xtompok/flipdot-driver/README.md

# flipdot-driver
Driver for flipdot displays
