xtompok/flipdot-driver/hw/flipdot-driver/flipdot-driver.kicad_pcb

## KiCad design hw/flipdot-driver/flipdot-driver.kicad_pcb (2019-07-27)

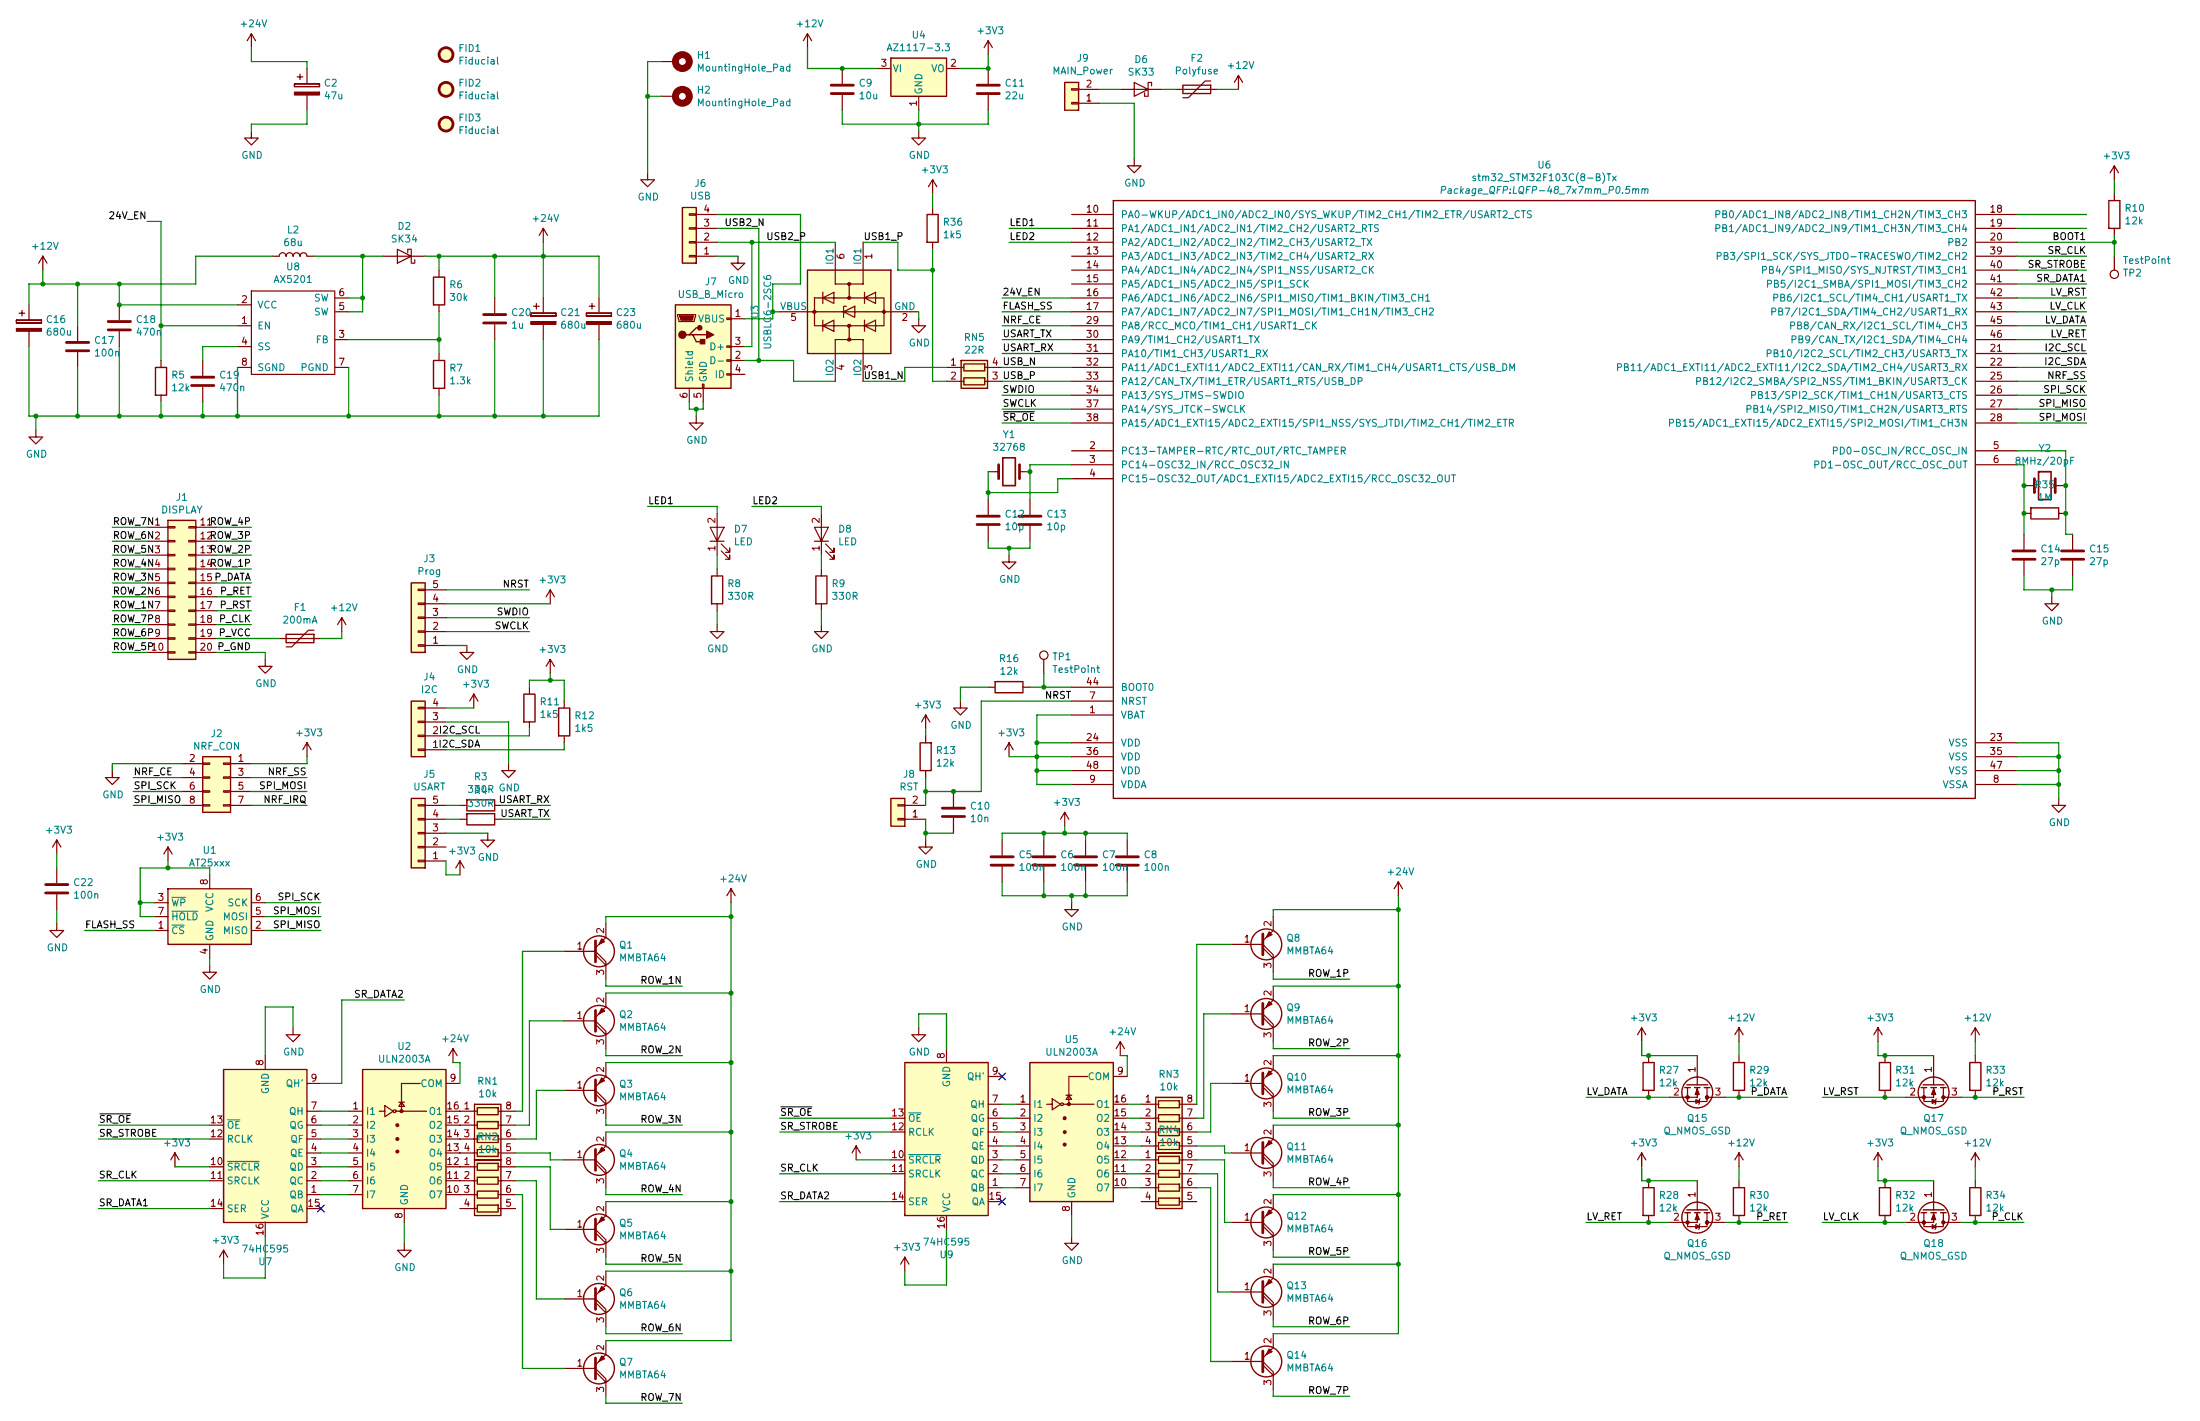
[picture p1: schematic flipdot-driver.sch, Flipdot Driver]

Parts:
C2: 47u; CP_Radial_D6.3mm_P2.50mm
C5, C6, C7, C8, C17, C22: 100n; C_0603_1608Metric
C9: 10u; C_0805_2012Metric
C10: 10n; C_0603_1608Metric
C11: 22u; C_0805_2012Metric
C12, C13: 10p; C_0603_1608Metric
C14, C15: 27p; C_0603_1608Metric
C16, C21, C23: 680u; CP_Radial_D10.0mm_P5.00mm
C18, C19: 470n; C_0603_1608Metric
C20: 1u; C_0603_1608Metric
D2: SK34; D_SMC
D6: SK33; D_SMC
D7, D8: LED; LED_D3.0mm
F1: 200mA; Fuse_1206_3216Metric
F2: Polyfuse; Fuse_1812_4532Metric
FID1, FID2, FID3: Fiducial; Fiducial_0.75mm_Dia_1.5mm_Outer
H1, H2: MountingHole_Pad; MountingHole_3.2mm_M3_DIN965_Pad
J1: DISPLAY; IDC-Header_2x10_P2.54mm_Vertical
J2: NRF_CON; PinSocket_2x04_P2.54mm_Vertical
J3: Prog; Molex_KK-254_AE-6410-05A_1x05_P2.54mm_Vertical
J4: I2C; Molex_KK-254_AE-6410-04A_1x04_P2.54mm_Vertical
J5: USART; Molex_KK-254_AE-6410-05A_1x05_P2.54mm_Vertical
J6: USB; Molex_KK-254_AE-6410-04A_1x04_P2.54mm_Vertical
J7: USB_B_Micro; USB_Micro-B
J8: RST; PinSocket_1x02_P2.54mm_Vertical
J9: MAIN_Power; PhoenixContact_MC-G_02x3.81mm_Angled
L2: 68u; L_12x12mm_H8mm
Q1, Q2, Q3, Q4, Q5, Q6, Q7, Q8, Q9, Q10, Q11, Q12, Q13, Q14: MMBTA64; SOT23-3
Q15, Q16, Q17, Q18: Q_NMOS_GSD; SOT-23
R3, R4, R8, R9: 330R; R_0603_1608Metric
R5, R10, R13, R16, R27, R28, R29, R30, R31, R32, R33, R34: 12k; R_0603_1608Metric
R6: 30k; R_0603_1608Metric
R7: 1.3k; R_0603_1608Metric
R11, R12, R36: 1k5; R_0603_1608Metric
R35: 1M; R_0603_1608Metric
RN1, RN2, RN3, RN4: 10k; R_Array_Convex_4x0603
RN5: 22R; R_Array_Convex_2x0402
TP1, TP2: TestPoint; TestPoint_THTPad_2.5x2.5mm_Drill1.2mm
U1: AT25xxx; SO-8_5.3x6.2mm_P1.27mm
U2, U5: ULN2003A; SOIC-16_3.9x9.9mm_P1.27mm
U3: USBLC6-2SC6; SOT-23-6
U4: AZ1117-3.3; SOT-223-3_TabPin2
U6: stm32_STM32F103C(8-B)Tx; LQFP-48_7x7mm_P0.5mm
U7, U9: 74HC595; SOIC-16_3.9x9.9mm_P1.27mm
U8: AX5201; HSOP-8-1EP_3.9x4.9mm_P1.27mm_EP2.41x3.1mm
Y1: 32768; Crystal_Round_D3.0mm_Vertical
Y2: 8MHz/20pF; Crystal_HC49-U_Vertical

Connections:
+3V3: C5.1, C6.1, C7.1, C8.1, C11.1, C22.1, J2.1, J3.4, J4.4, J5.1, Q15.1 (G), Q16.1 (G), Q17.1 (G), Q18.1 (G), R10.1, R11.1, R12.1, R13.2, R27.1, R28.1, R31.1, R32.1, R36.1, U1.3 (~WP), U1.7 (~HOLD), U1.8 (VCC), U4.2 (VO), U6.1 (VBAT), U6.9 (VDDA), U6.24 (VDD), U6.36 (VDD), U6.48 (VDD), U7.10 (~SRCLR), U7.16 (VCC), U9.10 (~SRCLR), U9.16 (VCC)
+12V: C9.1, C16.1, C17.1, C18.1, F1.1, F2.1, L2.1, R29.1, R30.1, R33.1, R34.1, U4.3 (VI), U8.2 (VCC)
+24V: C2.1, C20.1, C21.1, C23.1, D2.1 (K), Q1.2 (E), Q2.2 (E), Q3.2 (E), Q4.2 (E), Q5.2 (E), Q6.2 (E), Q7.2 (E), Q8.2 (E), Q9.2 (E), Q10.2 (E), Q11.2 (E), Q12.2 (E), Q13.2 (E), Q14.2 (E), R6.1, U2.9 (COM), U5.9 (COM)
/24V_EN: R5.1, U6.16 (PA6/ADC1_IN6/ADC2_IN6/SPI1_MISO/TIM1_BK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), U8.1 (EN)
/BOOT1: R10.2, TP2.1, U6.20 (PB2)
/FLASH_SS: U1.1 (~CS), U6.17 (PA7/ADC1_IN7/ADC2_IN7/SPI1_MOSI/TIM1_CH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)
/I2C_SCL: J4.2, R11.2, U6.21 (PB10/I2C2_SCL/TIM2_CH3/USART3_TX)
/I2C_SDA: J4.1, R12.2, U6.22 (PB11/ADC1_EXTI11/ADC2_EXTI11/I2C2_SDA/T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)
/LED1: D7.2 (A), U6.11 (PA1/ADC1_IN1/ADC2_IN1/TIM2_CH2/USART2_R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)
/LED2: D8.2 (A), U6.12 (PA2/ADC1_IN2/ADC2_IN2/TIM2_CH3/USART2_TX)
/LV_CLK: Q18.2 (S), R32.2, U6.43 (PB7/I2C1_SDA/TIM4_CH2/USART1_RX)
/LV_DATA: Q15.2 (S), R27.2, U6.45 (PB8/CAN_RX/I2C1_SCL/TIM4_CH3)
/LV_RET: Q16.2 (S), R28.2, U6.46 (PB9/CAN_TX/I2C1_SDA/TIM4_CH4)
/LV_RST: Q17.2 (S), R31.2, U6.42 (PB6/I2C1_SCL/TIM4_CH1/USART1_TX)
/NRF_CE: J2.4, U6.29 (PA8/RCC_MCO/TIM1_CH1/USART1_CK)
/NRF_IRQ: J2.7
/NRF_SS: J2.3, U6.25 (PB12/I2C2_SMBA/SPI2_NSS/TIM1_BKIN/USART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)
/NRST: C10.1, J3.5, J8.2, R13.1, U6.7 (NRST)
/P_CLK: J1.18, Q18.3 (D), R34.2
/P_DATA: J1.15, Q15.3 (D), R29.2
/P_RET: J1.16, Q16.3 (D), R30.2
/P_RST: J1.17, Q17.3 (D), R33.2
/P_VCC: F1.2, J1.19
/ROW_1N: J1.7, Q1.3 (C)
/ROW_1P: J1.14, Q8.3 (C)
/ROW_2N: J1.6, Q2.3 (C)
/ROW_2P: J1.13, Q9.3 (C)
/ROW_3N: J1.5, Q3.3 (C)
/ROW_3P: J1.12, Q10.3 (C)
/ROW_4N: J1.4, Q4.3 (C)
/ROW_4P: J1.11, Q11.3 (C)
/ROW_5N: J1.3, Q5.3 (C)
/ROW_5P: J1.10, Q12.3 (C)
/ROW_6N: J1.2, Q6.3 (C)
/ROW_6P: J1.9, Q13.3 (C)
/ROW_7N: J1.1, Q7.3 (C)
/ROW_7P: J1.8, Q14.3 (C)
/SPI_MISO: J2.8, U1.2 (MISO), U6.27 (PB14/SPI2_MISO/TIM1_CH2N/USART3_RTS)
/SPI_MOSI: J2.5, U1.5 (MOSI), U6.28 (PB15/ADC1_EXTI15/ADC2_EXTI15/SPI2_MOSI/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)
/SPI_SCK: J2.6, U1.6 (SCK), U6.26 (PB13/SPI2_SCK/TIM1_CH1N/USART3_CTS)
/SR_CLK: U6.39 (PB3/SPI1_SCK/SYS_JTDO-TRACESWO/TIM2_CH2), U7.11 (SRCLK), U9.11 (SRCLK)
/SR_DATA1: U6.41 (PB5/I2C1_SMBA/SPI1_MOSI/TIM3_CH2), U7.14 (SER)
/SR_DATA2: U7.9 (QH'), U9.14 (SER)
/SR_STROBE: U6.40 (PB4/SPI1_MISO/SYS_NJTRST/TIM3_CH1), U7.12 (RCLK), U9.12 (RCLK)
/SWCLK: J3.2, U6.37 (PA14/SYS_JTCK-SWCLK)
/SWDIO: J3.3, U6.34 (PA13/SYS_JTMS-SWDIO)
/USART_RX: R3.1, U6.31 (PA10/TIM1_CH3/USART1_RX)
/USART_TX: R4.1, U6.30 (PA9/TIM1_CH2/USART1_TX)
/USB1_N: RN5.1 (R1.1), U3.3 (IO2)
/USB1_P: R36.2, RN5.2 (R2.1), U3.1 (IO1)
/USB2_N: J6.3, J7.2 (D-), U3.4 (IO2)
/USB2_P: J6.2, J7.3 (D+), U3.6 (IO1)
/USB_N: RN5.4 (R1.2), U6.32 (PA11/ADC1_EXTI11/ADC2_EXTI11/CAN_RX/TIM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)
/USB_P: RN5.3 (R2.2), U6.33 (PA12/CAN_TX/TIM1_ETR/USART1_RTS/USB_DP)
/~SR_OE: U6.38 (PA15/ADC1_EXTI15/ADC2_EXTI15/SPI1_NSS/S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), U7.13 (~OE), U9.13 (~OE)
GND: C2.2, C5.2, C6.2, C7.2, C8.2, C9.2, C10.2, C11.2, C12.2, C13.2, C14.2, C15.2, C16.2, C17.2, C18.2, C19.2, C20.2, C21.2, C22.2, C23.2, H1.1, H2.1, J1.20, J2.2, J3.1, J4.3, J5.3, J6.1, J7.5 (GND), J7.6 (Shield), J8.1, J9.1, R5.2, R7.2, R8.2, R9.2, R16.2, U1.4 (GND), U2.8 (GND), U3.2 (GND), U4.1 (GND), U5.8 (GND), U6.8 (VSSA), U6.23 (VSS), U6.35 (VSS), U6.47 (VSS), U7.8 (GND), U8.7 (PGND), U8.8 (SGND), U9.8 (GND)
unnamed: C12.1, U6.4 (PC15-OSC32_OUT/ADC1_EXTI15/ADC2_EXTI15/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), Y1.1
unnamed: C13.1, U6.3 (PC14-OSC32_IN/RCC_OSC32_IN), Y1.2
unnamed: C14.1, R35.2, U6.6 (PD1-OSC_OUT/RCC_OSC_OUT), Y2.1
unnamed: C15.1, R35.1, U6.5 (PD0-OSC_IN/RCC_OSC_IN), Y2.2
unnamed: C19.1, U8.4 (SS)
unnamed: D2.2 (A), L2.2, U8.5 (SW), U8.6 (SW), U8.9 (EP)
unnamed: D6.1 (K), F2.2
unnamed: D6.2 (A), J9.2
unnamed: D7.1 (K), R8.1
unnamed: D8.1 (K), R9.1
unnamed: J5.4, R4.2
unnamed: J5.5, R3.2
unnamed: J6.4, J7.1 (VBUS), U3.5 (VBUS)
unnamed: Q1.1 (B), RN1.8 (R1.2)
unnamed: Q2.1 (B), RN1.7 (R2.2)
unnamed: Q3.1 (B), RN1.6 (R3.2)
unnamed: Q4.1 (B), RN1.5 (R4.2)
unnamed: Q5.1 (B), RN2.8 (R1.2)
unnamed: Q6.1 (B), RN2.7 (R2.2)
unnamed: Q7.1 (B), RN2.6 (R3.2)
unnamed: Q8.1 (B), RN3.8 (R1.2)
unnamed: Q9.1 (B), RN3.7 (R2.2)
unnamed: Q10.1 (B), RN3.6 (R3.2)
unnamed: Q11.1 (B), RN3.5 (R4.2)
unnamed: Q12.1 (B), RN4.8 (R1.2)
unnamed: Q13.1 (B), RN4.7 (R2.2)
unnamed: Q14.1 (B), RN4.6 (R3.2)
unnamed: R6.2, R7.1, U8.3 (FB)
unnamed: R16.1, TP1.1, U6.44 (BOOT0)
unnamed: RN1.1 (R1.1), U2.16 (O1)
unnamed: RN1.2 (R2.1), U2.15 (O2)
unnamed: RN1.3 (R3.1), U2.14 (O3)
unnamed: RN1.4 (R4.1), U2.13 (O4)
unnamed: RN2.1 (R1.1), U2.12 (O5)
unnamed: RN2.2 (R2.1), U2.11 (O6)
unnamed: RN2.3 (R3.1), U2.10 (O7)
unnamed: RN3.1 (R1.1), U5.16 (O1)
unnamed: RN3.2 (R2.1), U5.15 (O2)
unnamed: RN3.3 (R3.1), U5.14 (O3)
unnamed: RN3.4 (R4.1), U5.13 (O4)
unnamed: RN4.1 (R1.1), U5.12 (O5)
unnamed: RN4.2 (R2.1), U5.11 (O6)
unnamed: RN4.3 (R3.1), U5.10 (O7)
unnamed: U2.1 (I1), U7.7 (QH)
unnamed: U2.2 (I2), U7.6 (QG)
unnamed: U2.3 (I3), U7.5 (QF)
unnamed: U2.4 (I4), U7.4 (QE)
unnamed: U2.5 (I5), U7.3 (QD)
unnamed: U2.6 (I6), U7.2 (QC)
unnamed: U2.7 (I7), U7.1 (QB)
unnamed: U5.1 (I1), U9.7 (QH)
unnamed: U5.2 (I2), U9.6 (QG)
unnamed: U5.3 (I3), U9.5 (QF)
unnamed: U5.4 (I4), U9.4 (QE)
unnamed: U5.5 (I5), U9.3 (QD)
unnamed: U5.6 (I6), U9.2 (QC)
unnamed: U5.7 (I7), U9.1 (QB)

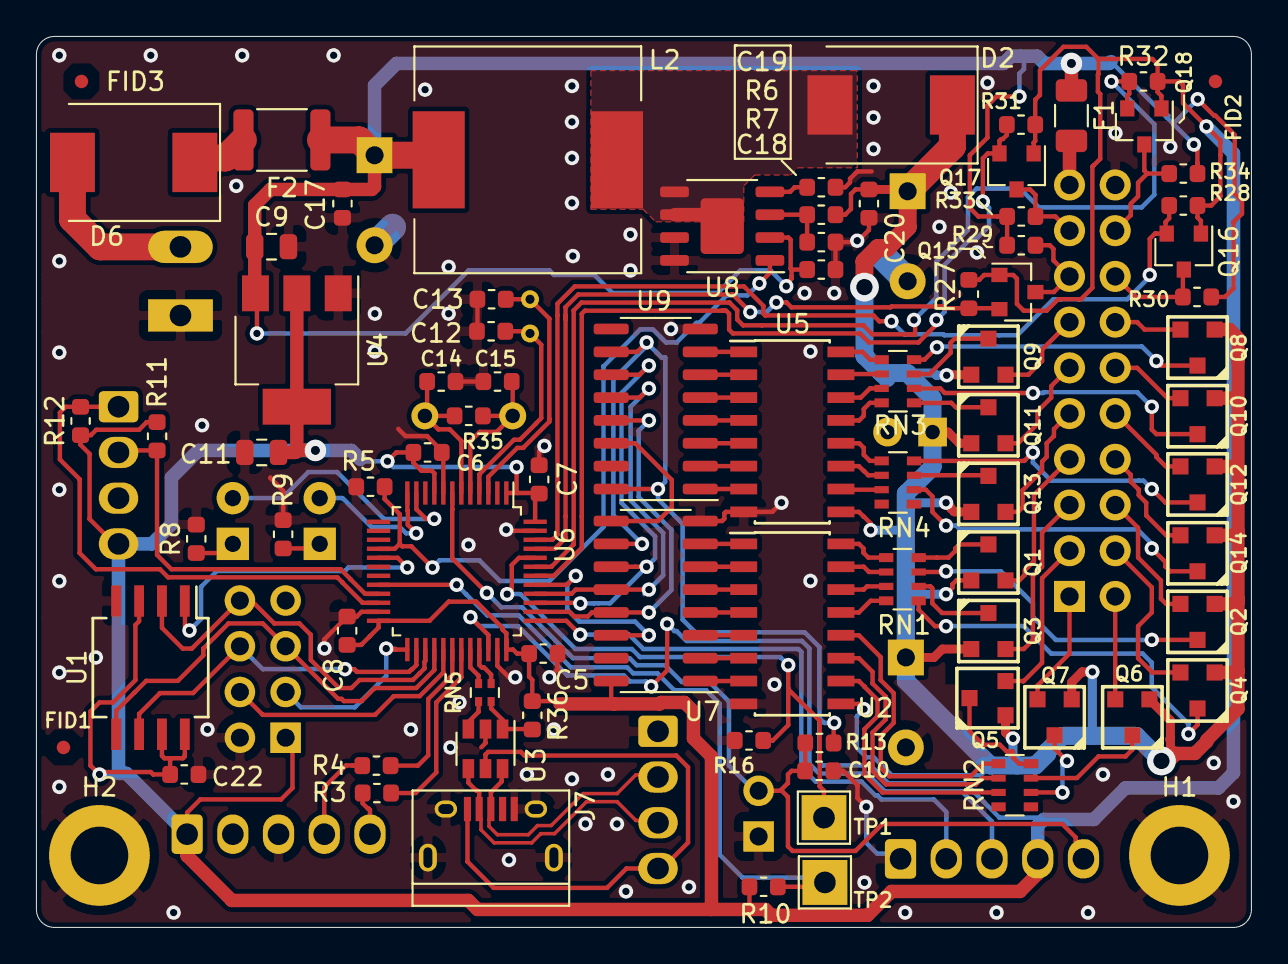
[picture p2: board flipdot-driver.kicad_pcb from above]

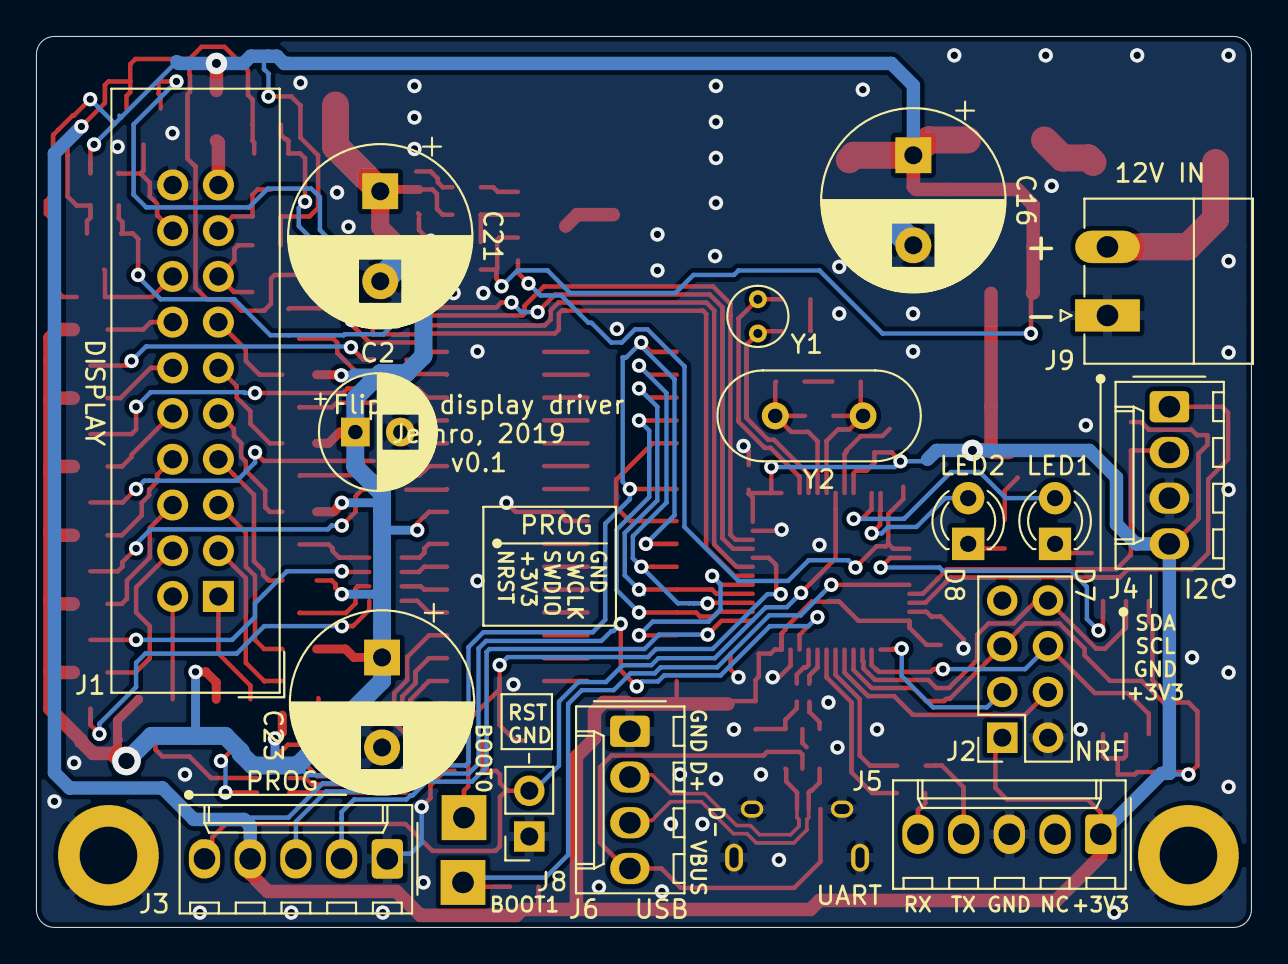
[picture p3: board flipdot-driver.kicad_pcb from below]

Board: 2 copper layers, 67.5 x 49.5 mm, 99 parts (16 on the bottom side), 112 nets.
