xtompok/flipdot-driver/(commit log)

2018-12-26 Added schematic stub.
    [flipdot-driver.kicad_pcb, flipdot-driver.sch]
2019-05-31 Last version before 74HC595.
    Only partially routed.
    [flipdot-driver.kicad_pcb, flipdot-driver.sch]
2019-05-31 Added 74HC595 and AX5201
    [flipdot-driver.kicad_pcb, flipdot-driver.sch]
2019-06-01 Routed, with unused parts.
    [flipdot-driver.kicad_pcb, flipdot-driver.sch]
2019-06-01 Routed, without unused parts.
    [flipdot-driver.kicad_pcb, flipdot-driver.sch]
2019-06-01 Placed labels, NRF connector mirrored.
    [flipdot-driver.kicad_pcb, flipdot-driver.sch]
2019-06-01 Forgotten labes.
    [flipdot-driver.kicad_pcb]
2019-06-01 Ready for manufacturing.
    [flipdot-driver.kicad_pcb, flipdot-driver.sch]
2019-06-01 Better ground planes.
    [flipdot-driver.kicad_pcb, flipdot-driver.sch]
2019-07-27 First software (only LED and USART test).
    [stm32f103.cfg]
2019-08-17 Countdown and timer.
